shmick/Espresso-PID-Controller/home-assistant/README.md

## Using the espresso controller with Home Assistant

The controller outputs JSON and the operational mode and boiler setpoint can be controlled via the HTTP server.

These are my config snippets from my own Home Assistant system

### Veritcal Stack Card
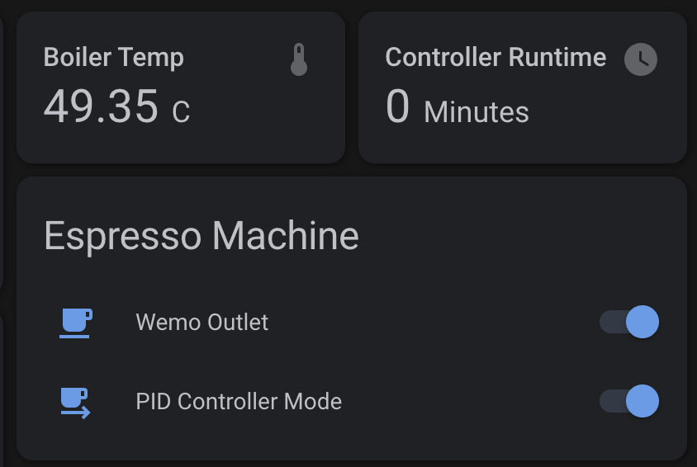
[picture p3: home-assistant/card.png]
Home Assistant Card
