shmick/Espresso-PID-Controller/single_ssr_120v.png

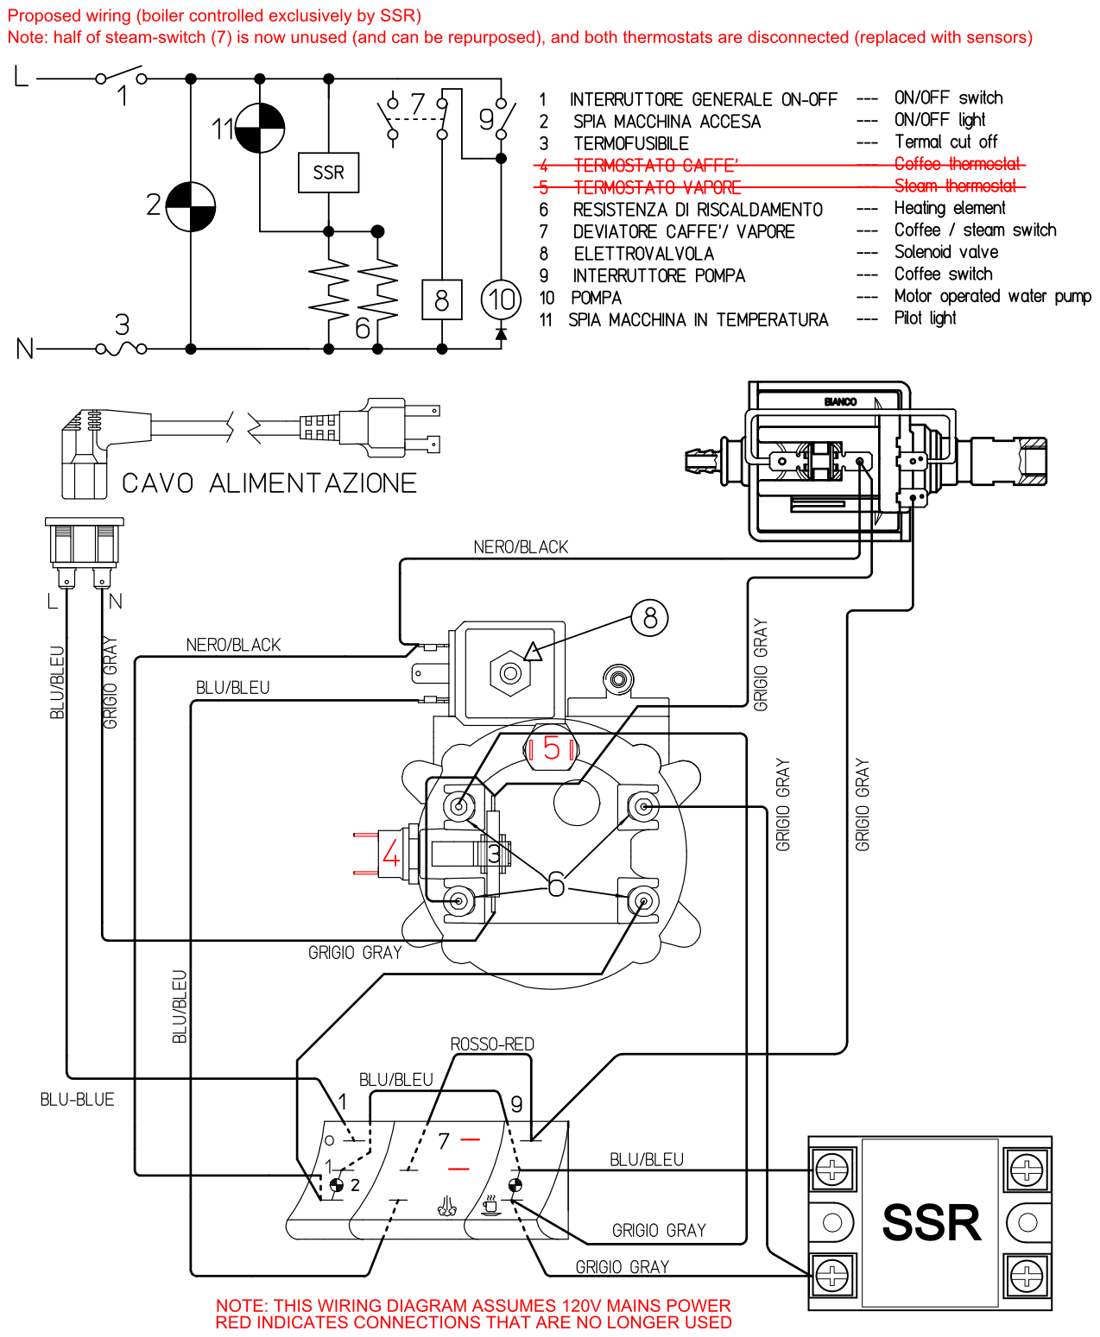
single_ssr_120v.png
