shmick/Espresso-PID-Controller/(list of files, drawings)

Other design files:
PCB/EasyEDA_PCB.json
PCB/EasyEDA_schematic.json
