shmick/Espresso-PID-Controller/(threads)

Thread 1 (2018-10-05):

Add AJAX to webpage for displaying and changing data

shmick, 2018-10-05:
For the ```controller-wemos_d1_mini-oled.ino``` sketch

1) PID Ouput ( Output )
2) Current Set Point ( Setpoint )

I'd also like to be able to change:
1) the value of **Setpoint**
2) the boolean state of **operMode**

xpokor02, 2020-01-06:
Hi ,
Did you finished code for changing Setpoint?
I tried to use your code but had to change relay pin to 15 (it is off when powering wemos) and IC pins to default so display works.
// Setup I2C pins
#define ESP_SDA 4
#define ESP_SCL 5
Now I wanted to figure out how you are controlling pid via web and found this.
Thanks

shmick, 2020-01-06:
For changing setpoint I'm using a basic POST call right now ie:

```curl -d "sp=105" http://espresso.local/set```

The code is at https://github.com/shmick/Espresso-PID-Controller/blob/master/controller-iotwebconf.ino#L459-L489

xpokor02, 2020-01-08:
Thank you for that, I saw function, but I initially forgot to specify method
```
<form action="/set" method="post">
  Setpoint:<br>
  <input type="number" name="sp" value="105"><br>
  <input type="submit" value="Submit">
  <input type="reset">
</form>
```
Works for me.

Closed 2020-12-24.

Thread 2 (2019-03-23):

K Type Thermocouple

tkaldridge88, 2019-03-23:
Have you had any issues with the accuracy of the thermocouple? Have you considered NTCs or RTDs? Thanks for all the information and hard work. I am planning to collect all the hardware this week to replicate your project.

Thanks, Kyle

shmick, 2019-03-25:
Hi Kyle,

The accuracy of the thermocouple is fine. The 10 bit ADC on the MCU was lacking in resolution, which is why I added the ADS1115 15 bit ADC into the mix.

I've been using a DS18B20 1-Wire thermometer in another project and it's working well.

tkaldridge88, 2019-03-25:
Thanks for the quick reply!

Are you still using the QIDI K thermocouple with this setup? Or different brand?

Do you happen to have a wiring sketch utilizing the ADS1115 with the AD8495? I'm far from an expert but could probably fumble my way through the design if not. Thanks for sharing your code!

shmick, 2019-03-25:
Still using the QIDI K, mostly because it has a 4mm end that threads into the 4mm hole on the boiler on the Gaggia.

Here's a schematic I started on, but haven't touched in a while:

https://imgur.com/nLn90YN

Here's the PCB layout I've got designed but haven't had made yet. I'm still running a crude protoboard setup.

https://imgur.com/OjCZa3f

shmick, 2019-05-06:
Closed

Closed 2019-05-06.

Thread 3 (2019-12-02):

wiring + photo of build

xpokor02, 2019-12-02:
Hi,
Do you have wiring diagram or text description of wiring? Plus I would love to see photo of your build how it look together.
Thanks

shmick, 2019-12-11:
The wiring diagram is shown at https://github.com/shmick/Espresso-PID-Controller/blob/master/single_ssr_120v.png

I've removed the the coffee thermostat and replaced it with a thermocouple. The relay now controls the power to the boiler rather than the bimetal thermostat. The steam thermostat is also not required as you can set the temperature to whatever you want.

xpokor02, 2019-12-21:
Hi shmick,
thanks for that, but I was also interested in seeing built and wiring of PID itself and how you integrated it into machine.
Thanks

shmick, 2020-12-24:
FYI I've added a some PCB files to the repo and you can see how I've got things integrated in a thread [here](https://coffeeforums.co.uk/topic/56699-my-espresso-pid-controller/).

Closed 2021-03-16.

Thread 7 (2021-01-09):

Homeassistant cards

xconverge, 2021-01-09:
First, wanted to say thanks, you saved me a TON of time with this project :) I added PID autotuning and some EEPROM storage, but besides that, I have some very similar needs/desires as your project, I probably could have just used yours exactly as is but wanted to build it up as I went. I wanted to stop my waiting around/temp surfing, but overall have the exact same buttons/interface, without needing to fiddle with anything once it was setup and installed within the machine.

https://github.com/xconverge/gaggia-pid/blob/main/project/project.ino

Second, you might want to add   unit_of_measurement: 'degrees' to your sensor.yaml for the temps, this allows you to have nice plots if you wanted. I plan on using the mqtt data to tune PID a bit, then will probably turn mqtt off.

but mostly just wanted to say thanks!

shmick, 2021-01-09:
You're very welcome. Glad my efforts can help others on their way to great coffee.

Thanks for the tip about the HA cards, I'll look into that. My personal preference is to use HA to simply control the on/off state and check if the machine is ready.

Closed 2021-01-09.

Thread 11 (2021-03-15):

Feature Request: Pressure Sensor & Pump Control

CaptInsano, 2021-03-15:
Really interested in this project, I am looking to add a PID to my Gaggia Classic but really wanted it to be smart (added to my homeassistant setup) just like your system. I also love the fact that the  external of the machine is untouched.

Would it be possible to add a water pressure sensor to this setup?

Something like this:  https://www.amazon.co.uk/Qiman-Pressure-Converter-Sensor-Transmitter/dp/B07MW4MJFG

discussion about adding it to tasmota here:  https://github.com/arendst/Tasmota/issues/6000

It would cool to see the pressure profile over time and possibly add pressure control by pulsing the pump via SSR.
topic regarding same here: http://www.gaggiausersgroup.com/index.php?topic=990.0

The addition of a pump control SSR would also allow running perfectly timed shots.

Great work!

rvt, 2021-03-15:
Loos interesting for my little project aswell...
How is the ressure sensor attached to the Gaggia? I could not find that in the link yet...

CaptInsano, 2021-03-15:
I was thinking of attaching it via a T-junction between the pump and the group head like the tradition pressure sensors.

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

shmick, 2021-03-17:
@CaptInsano,

I don't have plans to add any additional functionality to the project at the moment. I'm only using 1 of the 4 ADS1115 inputs, so adding an analog pressure transducer to one of the free inputs should work fine. Keep in mind that you'll want to put the output through a voltage divider as the ADS1115 is running off 3.3v and the transducer is 0-5v.

Even 1 SSR + the PCB inside the case is a tight fit, so I'd be wary of adding a 2nd SSR to control the pump.

I originally had an OLED display to watch the temperature and ended up not using it because I know after 8 minutes or so that the machine is at temp and now I can use Home Assistant to verify that as well.

The HA integration was more so that I could remotely fire up the boiler any time so that the machine was ready to go without me having to wait for it to warm up.

I'm also not concerned about the pressure readout, but if I did want to know, I'd probably go with the analog kit, otherwise I'd need to re-add the OLED display or keep an eye on HA as the shot is being pulled, which isn't something I'm too interested in doing.

If you'd like to add the functionality, feel free to do so and send me a pull request!

Cheers.

Closed 2022-04-17.

Thread 12 (2021-06-22):

PID loop is unstable when MQTT server cannot be reached

shmick, 2021-06-22:
### Description
PID controller becomes unstable when the MQTT server cannot be reached

#### Steps to Reproduce
* Have MQTT enabled
* Shut down the MQTT broker
* Observe the setpoint and PID output via the stats page

#### Expected Results
PID controller maintains setpoint

#### Actual Results
PID output appears to be off or much lower than required to maintain setpoint

#### Workaround
Disable MQTT in the web config

Closed 2022-04-20.
