shmick/Espresso-PID-Controller/(commit log)

2020-12-07 add PCB files
    [EasyEDA_PCB.json, EasyEDA_schematic.json]
2020-12-07 update Gerber file
2020-12-07 update board image
2020-12-20 code cleanup + steam switch addition
2020-12-21 reset thingName to espresso
    [Espresso-PID-Controller.ino]
2020-12-21 debounce the steam switch
2020-12-29 fix comment for operMode default value
    [Espresso-PID-Controller.ino]
2021-01-07 2021-01-06 add maxBoilerTemp for auto shutoff. require operMode to be false to reset operMode with steam switch
    [Espresso-PID-Controller.ino]
2021-01-13 2021-01-13 add MQTT LWT + small bug fix and small code cleanup
    [Espresso-PID-Controller.ino]
2021-01-14 Fix: Enable PID on startup if operMode = true
    [Espresso-PID-Controller.ino]
